SkillsHUB-Electronics/camel-crossing-v1/docs/screenshots/road_idle_1720.png

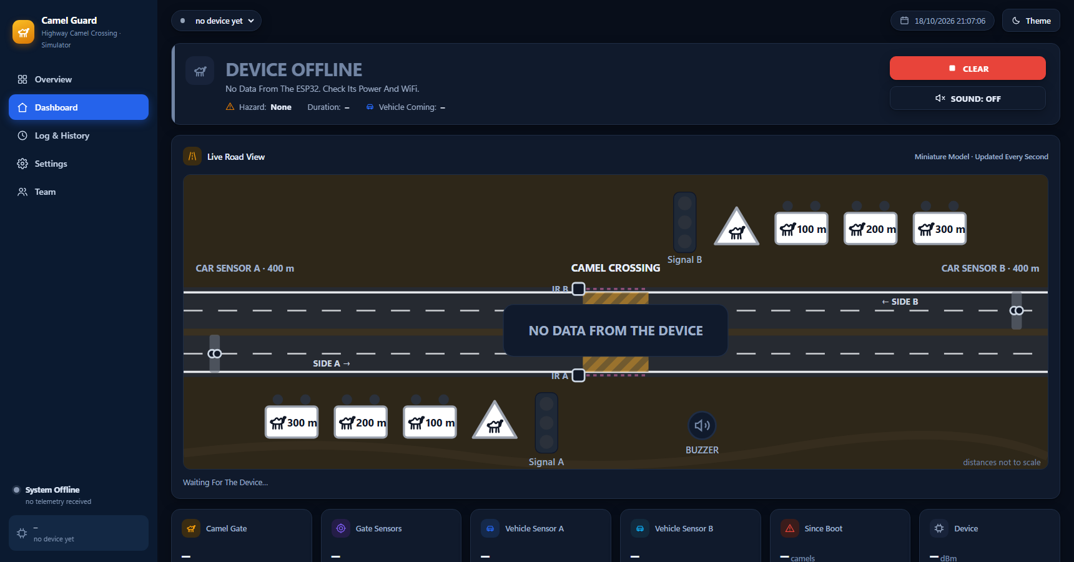
docs/screenshots/road_idle_1720.png
