SkillsHUB-Electronics/camel-crossing-v1/proposal/images/dashboard_overview.png

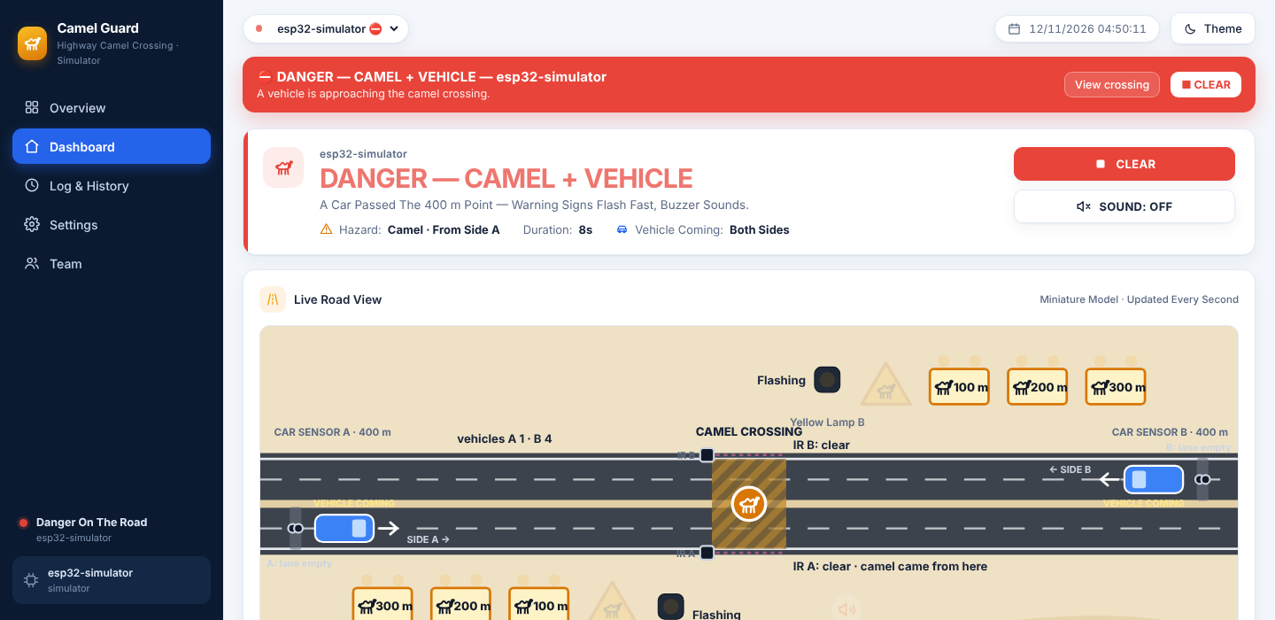
proposal/images/dashboard_overview.png
