SkillsHUB-Electronics/camel-crossing-v1/3d/Car Sensor Gate.stl

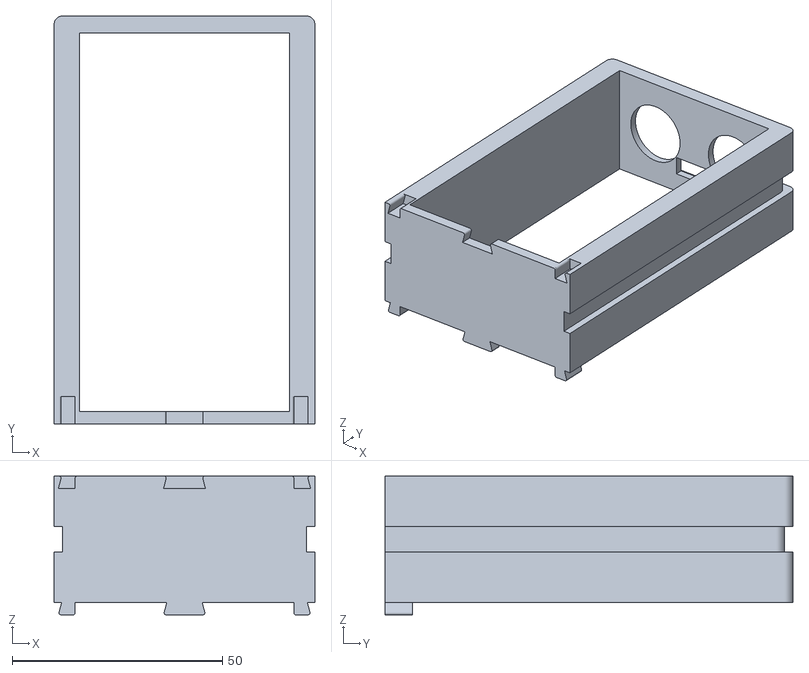
[picture p38: CAD file, 2026-10-18]
3d/Car Sensor Gate.stl
62.0 x 97.0 x 33.0
