SkillsHUB-Electronics/camel-crossing-v1/3d/road.stl

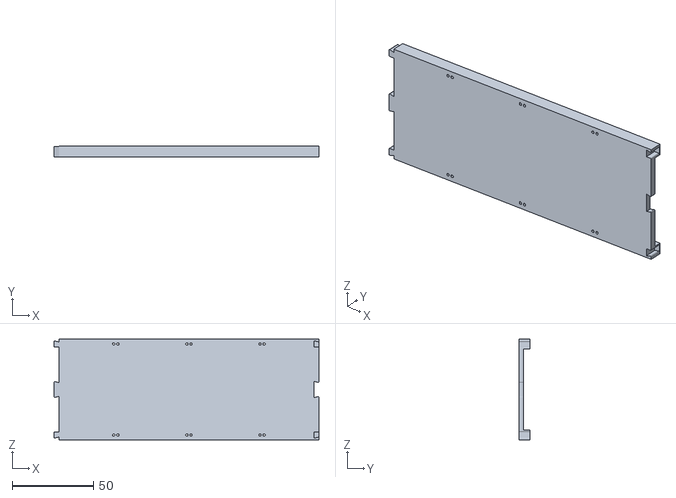
[picture p39: CAD file, 2026-10-18]
3d/road.stl
163.0 x 7.00 x 62.0
