SkillsHUB-Electronics/camel-crossing-v1/3d/Camel Gate.stl

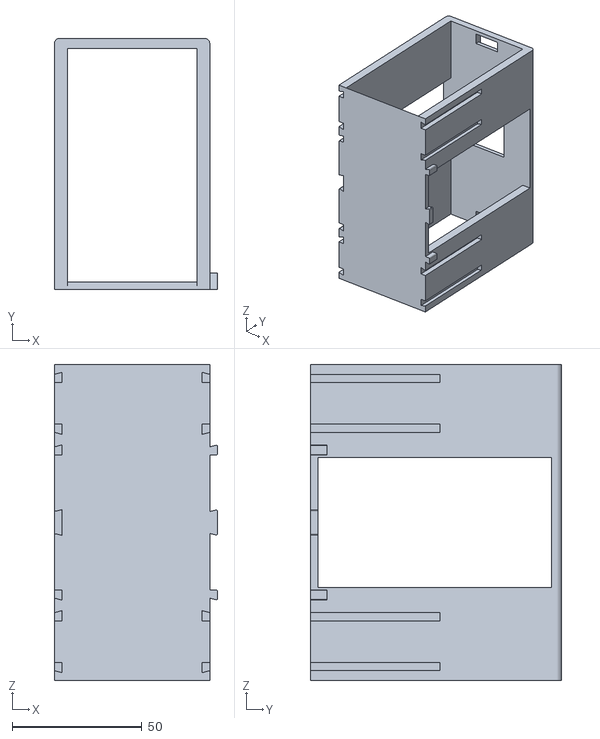
[picture p40: CAD file, 2026-10-18]
3d/Camel Gate.stl
63.0 x 97.0 x 122.0
