SkillsHUB-Electronics/camel-crossing-v1/3d/Camel Pedestrian.3mf

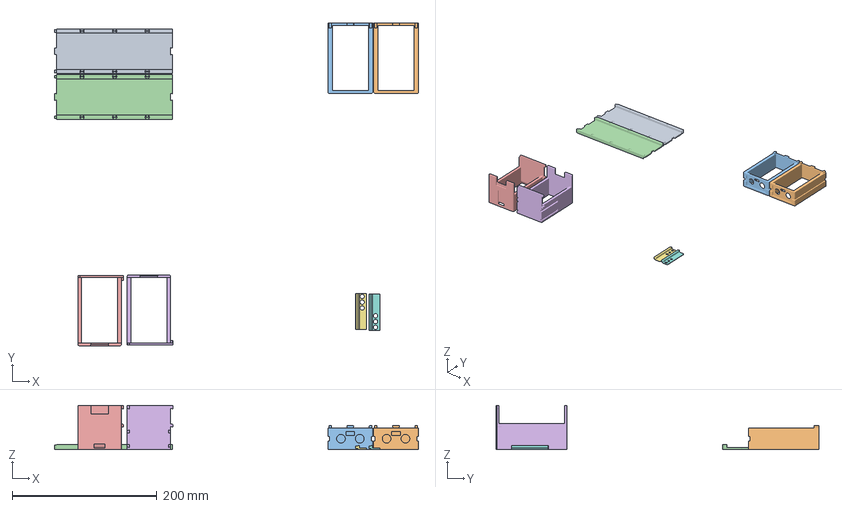
[picture p41: CAD file, 2026-10-18]
3d/Camel Pedestrian.3mf
502.2 x 445.3 x 61.0 mm
road.stl x 2
Car Sensor Gate.stl x 2
Camel Gate.stl x 2
Trafic LED_MIR.stl
Trafic LED.stl
