SkillsHUB-Electronics/camel-crossing-v1/3d/Trafic LED_MIR.stl

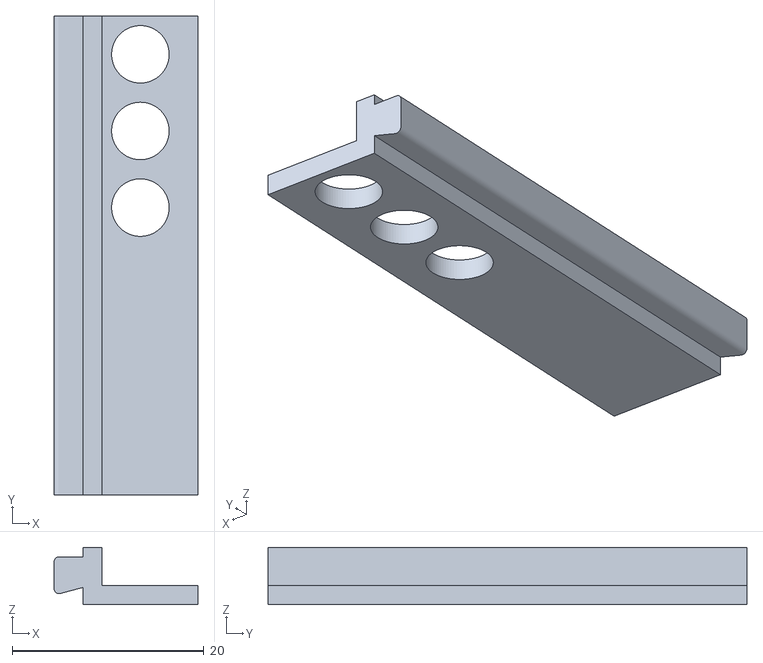
[picture p42: CAD file, 2026-10-18]
3d/Trafic LED_MIR.stl
15.0 x 50.0 x 6.00
