SkillsHUB-Electronics/camel-crossing-v1/(list of files, cad)

Other CAD files:
3d/Trafic LED.stl
3d/Camel Gate.ipt
3d/Camel Pedestrian.iam
3d/Car Sensor Gate.ipt
3d/Trafic LED.ipt
3d/Trafic LED_MIR.ipt
3d/road.ipt
