SkillsHUB-Electronics/camel-crossing-v1/proposal/Advanced Camel and Pedestrian Hazard Detection & Road Safety System.docx

Electrical Engineering (ENE)
Graduation Project

Project Title: Advanced Camel and Pedestrian Hazard Detection & Road Safety System.

School Name:
ATS-DHF

Supervisor Name:
Haitham Zein

Student Names:
1. Mohamed Mubarak Almansoori
2. Mohammed Jumaa
3. Mansoor Abdulla
4. Ibrahim Jumaa

G11 Term 3 Overview

The Engineering Capstone Project allows students to apply engineering knowledge and practical skills to solve real-world problems. This project focuses on improving road safety in the UAE through the development of a Smart Camel and Pedestrian Crossing Warning System.

# Project Title and Description

This project focuses on designing and developing a smart warning system that detects camels or pedestrians near roads and alerts drivers automatically using flashing LED warning lights. The system uses motion sensors, Arduino programming, and automated warning signals to improve safety in desert and remote road areas.

# Problem Statement

In the UAE, camels and pedestrians may crossroads unexpectedly, especially during nighttime or low visibility conditions. This can cause serious accidents, injuries, and vehicle damage. There is a need for a smart and automated warning system that can detect movement near roads and alert drivers before accidents occur.

# Abstract

The Advanced Camel and Pedestrian Crossing Warning System is an innovative engineering project designed to improve road safety in desert and remote areas of the UAE. The project addresses the increasing risk of traffic accidents caused by unexpected camel and pedestrian crossings, especially during nighttime and low-visibility conditions. Traditional warning signs provide static alerts and cannot respond to real-time movement, which creates a need for a smarter and more effective safety solution.

This project presents a prototype system that uses a PIR motion sensor connected to an Arduino Uno microcontroller to detect movement near road crossings. Once movement is detected, the system automatically activates flashing LED warning lights and a buzzer to alert approaching drivers. The prototype demonstrates how automation and embedded systems can enhance public safety using low-cost and energy-efficient technologies.

The project also introduces advanced innovative features such as low power consumption, smart warning operation, night-mode detection, and the possibility of solar-powered functionality for remote desert roads. The system is designed to be simple, reliable, and adaptable for future smart road applications in the UAE.

The expected outcome is a functional smart warning system capable of reducing accident risks and increasing driver awareness. This project highlights the importance of integrating engineering, electronics, and automation technologies to develop practical solutions that support safer transportation infrastructure and sustainable smart city initiatives in the UAE.

# Background Research

Camel crossing accidents are a known issue in desert areas of the UAE. Traditional road signs remain static and cannot detect real movement. Modern technologies such as motion sensors, Arduino microcontrollers, and LED warning systems can create a smarter and more effective road safety solution.

# Project Scope

The project includes building a small working prototype that detects movement near roads and activates warning lights automatically. The project includes Arduino programming, sensor integration, and LED warning systems. The project does not include full highway implementation or AI camera systems.

# Materials, Tools, and Resources Required

• Arduino Uno

• PIR Motion Sensor

• LED Warning Lights

• Breadboard

• Jumper Wires

• Buzzer

• Power Supply

• Mini Road Prototype

• Arduino IDE Software

• Laptop

• Basic Assembly Tools

# Expected Outcomes

The project is expected to detect movement successfully and activate warning lights automatically. The system should improve road safety awareness and demonstrate a practical smart safety solution suitable for UAE desert roads.

# System Design / Block Diagram

Motion Sensor → Arduino → Relay Module → LED Warning Lights / Buzzer

# Safety Considerations

Low-voltage components will be used during testing. Electrical wires will be insulated properly, and exposed connections will be avoided for safety.

# Advanced Innovative Features

• Solar-powered operation for remote desert roads.

• Smart flashing LED warning lights.

• Dual detection system for camels and pedestrians.

• Night mode for improved low-visibility detection.

• Low power consumption system.

• Potential future mobile notification integration.

# Future Improvements

Future improvements may include AI camera detection, mobile warning systems, speed reduction alerts, and integration with smart road systems.

Prepared according to the ATS Electrical Engineering Capstone Project Workbook requirements.
