SkillsHUB-Electronics/camel-crossing-v1/(commit log)

2026-10-18 Camel Guard: camel crossing highway safety (ESP32 miniature simulator)
    Table-top highway model that warns drivers when a camel crosses.
    - Firmware 2.3.1 (ESP32, Arduino): camel gate with 2x IR obstacle
    sensors (side A / side B) + PIR between them for confirmation and
    direction; 2x HC-SR04 at the 400 m point of each approach detect
    passing cars and make that side's warning signs flash fast; UAE
    signal sequence, 300/200/100 m signs via 2x 74HC595, buzzer,
    solar + battery monitoring with 2x INA219, settings in NVS.
    Sensor pins/defaults in sensors_config.h; config.h (WiFi
    credentials) is not committed.
    - Dashboard (Python stdlib server + single-page UI): live road view,
    charts,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
    [Camel Gate.ipt, Camel Gate.stl, Camel Pedestrian.3mf, Camel Pedestrian.iam, Car Sensor Gate.ipt, Car Sensor Gate.stl, Trafic LED.ipt, Trafic LED.stl]
2026-10-19 Dashboard: deployable to Render (cloud mode with login)
    - server.py: cloud mode when RENDER or CG_CLOUD=1 is set. It refuses
    to start without DASHBOARD_PASSWORD (HTTP Basic on every page and
    API except /healthz); DEVICE_KEY makes POST /api/telemetry require
    the X-Device-Key header; UDP discovery is skipped. The "Dashboard
    Address" field accepts host:port (a pasted https:// is removed).
    Local mode without these variables is unchanged.
    - Firmware: a dashboard on port 443 is reached over HTTPS
    (WiFiClientSecure, certificate not checked, 6 s timeouts); optional
    DEVICE_KEY (default empty in sensors_config.h, defined by the user
    in config.h, which stays out of git).
    - render.yaml (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
    [camel_guard_esp32.ino, sensors_config.h]
2026-11-12 Remove PIR, single flashing yellow lamp, one 74HC595 (fw 2.4.0)
    * Remove PIR, single flashing yellow lamp, one 74HC595 (firmware 2.4.0)
    Camel = IR A/B alone. One always-flashing yellow lamp replaces the R/A/G
    signals; sides A and B (lamp and 300/200/100 m signs) share one output, so a
    single 74HC595 is enough. Simulator, server, dashboard, wiring/diagrams and
    docs follow; HC-SR04 car sensors and local/cloud modes are unchanged.
    Claude-Session: https://claude.ai/code/session_0163WgGHsVieD6nsu3rsjbcm
    * Proposal v3.4: IR-only camel gate, yellow lamp, one 74HC595; re-render diagrams and screenshots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
    [camel_guard_esp32.ino, make_proposal.js, sensors_config.h]
2026-11-12 Warning signs keep flashing at 1 Hz while a camel crosses (fw 2.4.1)
    Claude-Session: https://claude.ai/code/session_0163WgGJ2u1nDLnHjuaxKjGt
2026-11-12 Swap 74HC595 clock/latch pins: SH_CP = D19, ST_CP = D18 (#3)
    Claude-Session: https://claude.ai/code/session_0163WgGGkpqrdP3cYZW13NZz
    [make_proposal.js]
